michaelcanudas/CPSC-3340-Final-Project/puzzle_present_match/cad/Feet.stl

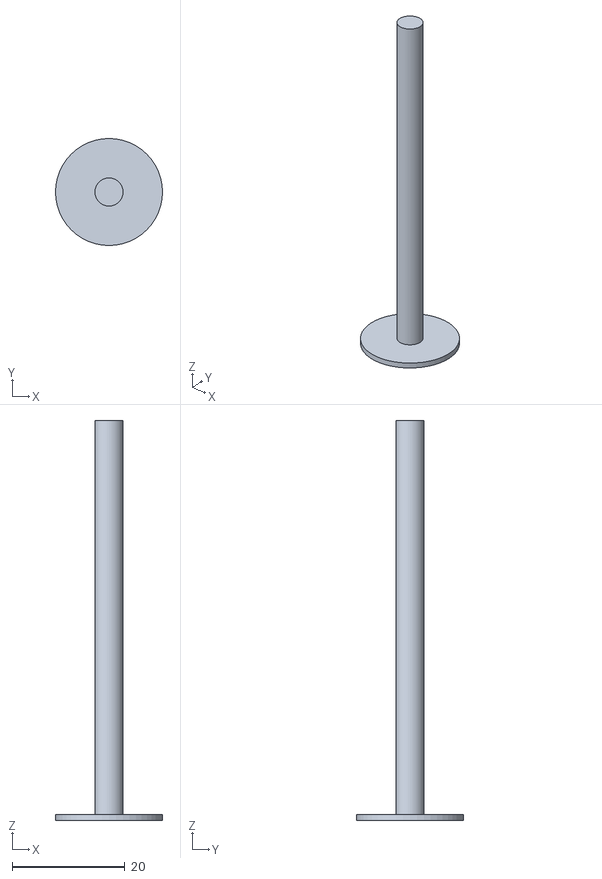
[picture p5: CAD file, 2025-12-07]
puzzle_present_match/cad/Feet.stl
19.0 x 19.0 x 71.0
