michaelcanudas/CPSC-3340-Final-Project/puzzle_sleigh/main.py

import socket
import threading
import time
import signal
import sys
from gpiozero import DigitalInputDevice, DigitalOutputDevice


HOST = '193.122.147.106'
PORT = 7531

HALL_PIN = 14
RELAY_PIN = 2

hall = DigitalInputDevice(HALL_PIN, pull_up=True)
relay = DigitalOutputDevice(RELAY_PIN)

running = True


def activate():
    relay.on()
    print('Activated')


def deactivate():
    relay.off()
    print('Deactivated')


def send_to_server(conn, message):
    if conn is None:
        return
    try:
        conn.send(message.encode())
        print(f'Sent message to server: {message}')
    except Exception as e:
        print(f'Failed to send message to server: {message} ({e})')

def magnet_update(conn, stop_event):
    hall_was_active = False
    print("Hall is active: " + str(hall.is_active))
    while not stop_event.is_set() and running:
        if hall.is_active and not hall_was_active:
            send_to_server(conn, 'event:sleigh_magnet:true')
        elif not hall.is_active and hall_was_active:
            send_to_server(conn, 'event:sleigh_magnet:false')

        hall_was_active = hall.is_active
        time.sleep(0.1)


def receive_from_server(conn, stop_event):
    try:
        while running and not stop_event.is_set():
            command = conn.recv(1024).decode()
            if not command:
                break

            command = command.strip()
            if command == 'activate':
                activate()
            elif command == 'deactivate':
                deactivate()

    except Exception as e:
        print(f'Server read error: {e}')

    finally:
        stop_event.set()
        try:
            conn.close()
        except:
            pass


def connect():
    while running:
        try:
            s = socket.socket(socket.AF_INET, socket.SOCK_STREAM)
            s.connect((HOST, PORT))
            print('Connected to server')

            s.send('sleigh'.encode())
            return s

        except Exception as e:
            print(f'Connection failed, retrying in 2s... ({e})')
            time.sleep(2)

    return None


def start_client():
    global running
    while running:
        conn = connect()
        if conn is None:
            break

        stop_event = threading.Event()

        magnet_thread = threading.Thread(
            target=magnet_update,
            args=(conn, stop_event),
            daemon=True
        )
        magnet_thread.start()

        receive_from_server(conn, stop_event)

        print('Disconnected from server, reconnecting...')
        stop_event.set()
        time.sleep(1)


def shutdown():
    global running
    running = False
    deactivate()
    print('Shutting down...')
    sys.exit(0)


signal.signal(signal.SIGINT, lambda sig, frame: shutdown())

deactivate()
start_client()
