michaelcanudas/CPSC-3340-Final-Project/(commit log)

2025-12-04 Printer code
2025-12-05 relay client
2025-12-10 Add blog post template; clean up repo
    [Feet.stl, pyvenv.cfg]
2025-12-12 Wiring Diagrams
    Wiring diagrams for all 4 puzzles
2025-12-12 Edited environmental effects section in blog.md
    Added details about environmental effects, including the receipt printer and relay control for lighting.
2025-12-12 Enhance Puzzle 3 description with wiring and design details
    Added detailed explanation of the sleigh puzzle's wiring, software logic, and physical construction challenges, including laser cutting issues and design precision.
